broncoracing/bspd/README.md

# BSPD 
Bronco Racing Brake System Plausibility Device

Note: with the "no latch" option selected on the jumpers the output is inverted :(
