broncoracing/bspd/pcb/BSPD.kicad_pcb

## KiCad design pcb/BSPD.kicad_pcb (2023-02-06)

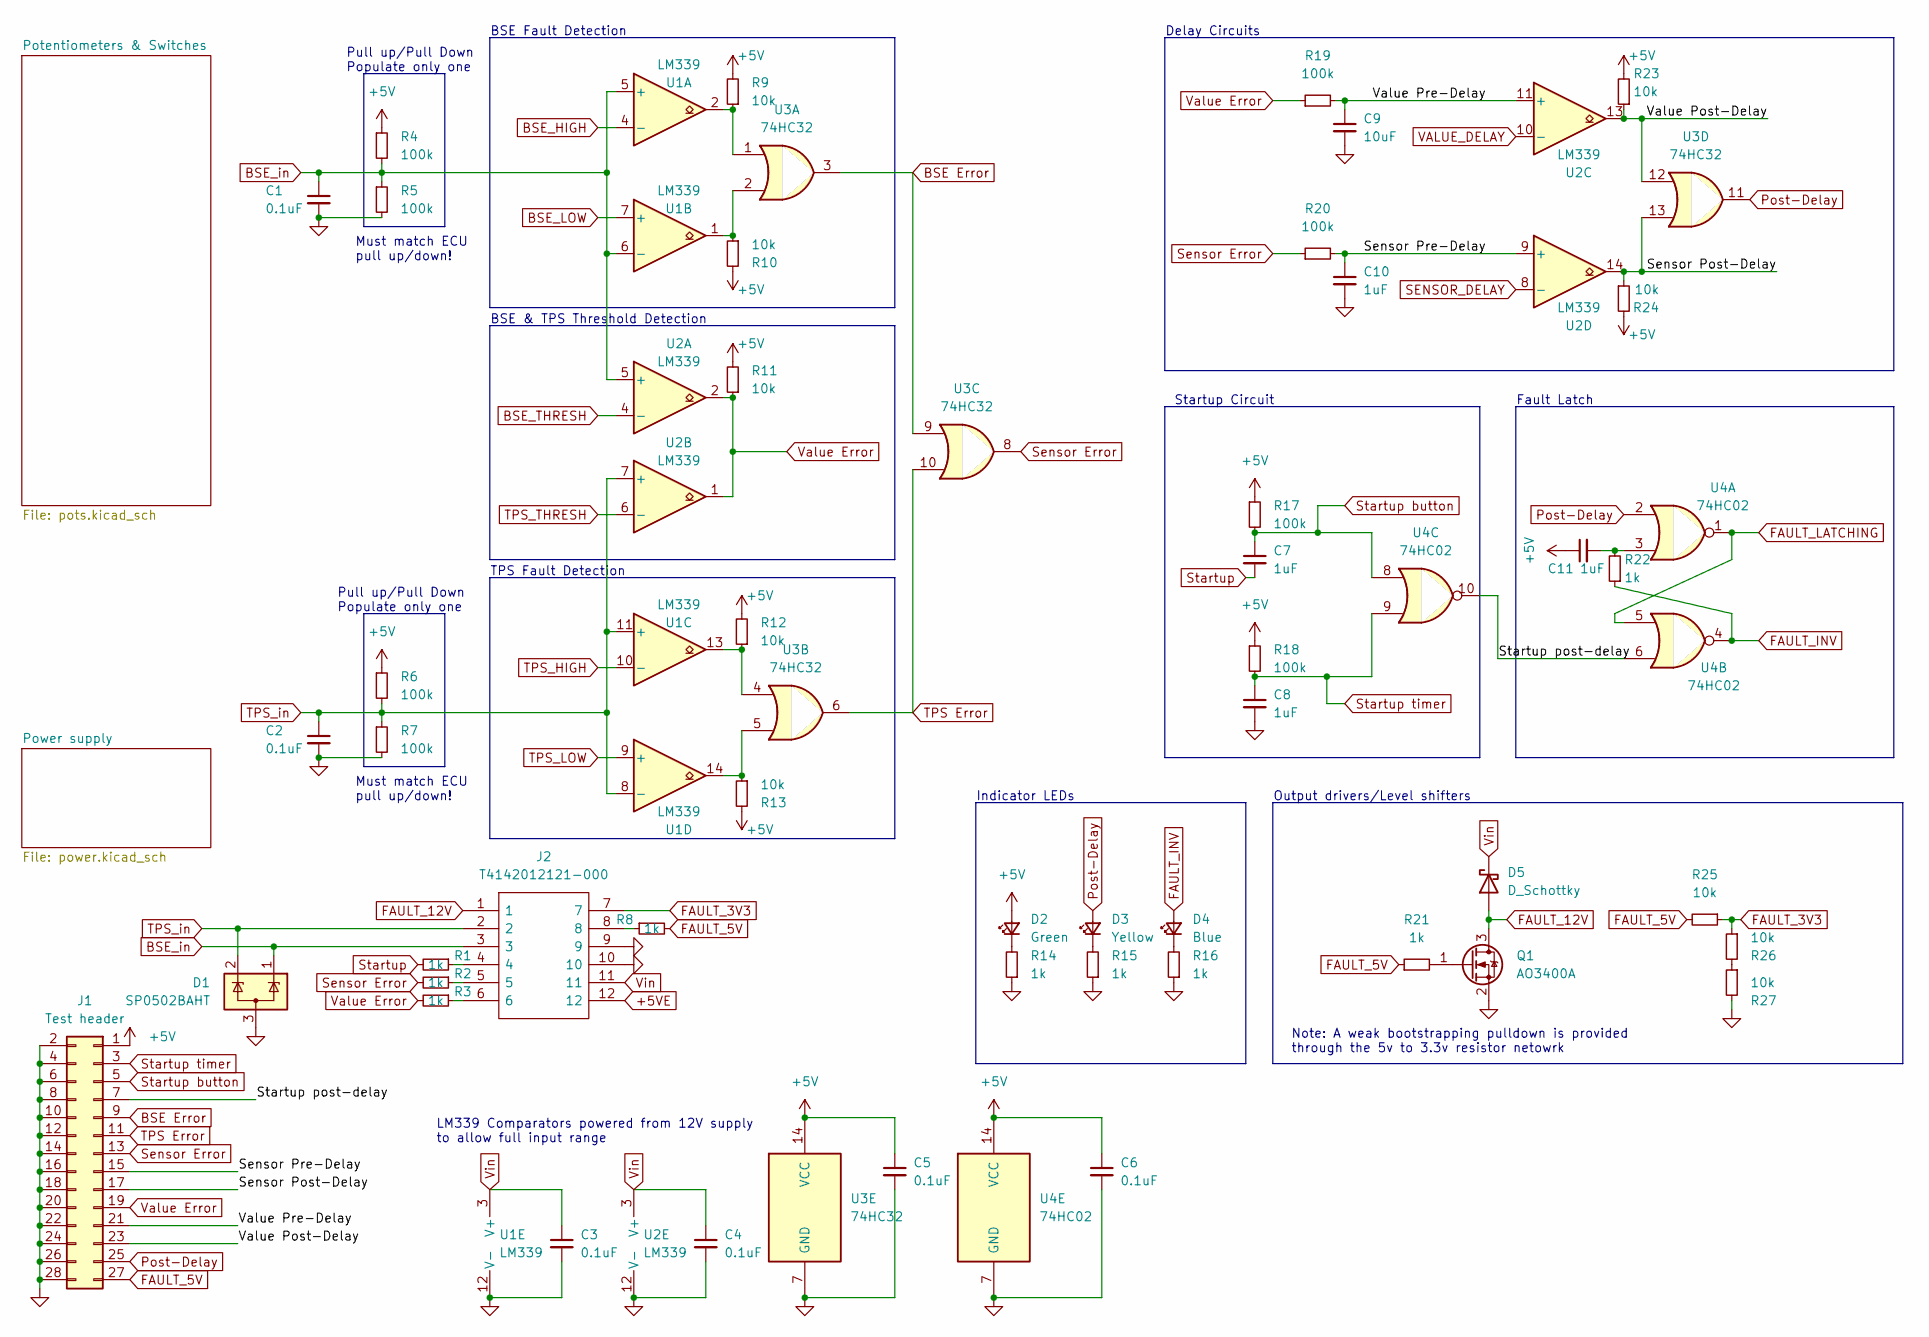
[picture p1: schematic BSPD.kicad_sch, Brake System Plausibility Device]

Parts:
C1, C2, C3, C4, C5, C6: 0.1uF; C_0402_1005Metric; LCSC C307331
C7, C8, C10, C11: 1uF; C_0402_1005Metric; LCSC C52923
C9: 10uF; C_0805_2012Metric; LCSC C440198
D1: SP0502BAHT; SOT-23; LCSC C32677
D2: Green; LED_0603_1608Metric; LCSC C72043
D3: Yellow; LED_0603_1608Metric; LCSC C72038
D4: Blue; LED_0603_1608Metric; LCSC C72041
D5: D_Schottky; D_SOD-323; LCSC C191023
J1: Test header; PinHeader_2x14_P2.54mm_Vertical
J2: T4142012121-000; T4140012121000; Mouser Part Number 571-T4142012121-000
Q1: AO3400A; SOT-23; LCSC C20917
R1, R2, R3, R8, R14, R15, R16, R21, R22: 1k; R_0402_1005Metric; LCSC C11702
R4, R5, R6, R7, R17, R18, R19, R20: 100k; R_0402_1005Metric; LCSC C25741
R9, R10, R11, R12, R13, R23, R24, R25, R26, R27: 10k; R_0402_1005Metric; LCSC C25744
U1, U2: LM339; SOIC-14_3.9x8.7mm_P1.27mm; LCSC C63821
U3: 74HC32; SOIC-14_3.9x8.7mm_P1.27mm; LCSC C6838
U4: 74HC02; SOIC-14_3.9x8.7mm_P1.27mm; LCSC C5588

Connections:
+5V: C5.1, C6.1, C11.1, D2.2 (A), J1.1, R4.1, R6.1, R9.2, R10.2, R11.2, R12.2, R13.2, R17.1, R18.1, R23.2, R24.2, U3.14 (VCC), U4.14 (VCC); also elsewhere on the board
+5VE: J2.12; also elsewhere on the board
/Sensor Post-Delay: J1.17, R24.1, U2.14, U3.13
/Sensor Pre-Delay: C10.1, J1.15, R20.2, U2.9 (+)
/Startup post-delay: J1.7, U4.6, U4.10
/Value Post-Delay: J1.23, R23.1, U2.13, U3.12
/Value Pre-Delay: C9.1, J1.21, R19.2, U2.11 (+)
BSE Error: J1.9, U3.3, U3.9
BSE_HIGH: U1.4 (-); also elsewhere on the board
BSE_LOW: U1.7 (+); also elsewhere on the board
BSE_THRESH: U2.4 (-); also elsewhere on the board
BSE_in: C1.1, D1.1 (K), J2.3, R4.2, R5.1, U1.5 (+), U1.6 (-), U2.5 (+)
FAULT_3V3: J2.7, R25.1, R26.1
FAULT_5V: J1.27, R8.2, R21.1, R25.2; also elsewhere on the board
FAULT_12V: D5.2 (A), J2.1, Q1.3 (D)
FAULT_INV: D4.2 (A), R22.1, U4.4
FAULT_LATCHING: U4.1, U4.5; also elsewhere on the board
GND: C1.2, C2.2, C3.2, C4.2, C5.2, C6.2, C8.2, C9.2, C10.2, D1.3 (A), J1.2, J1.4, J1.6, J1.8, J1.10, J1.12, J1.14, J1.16, J1.18, J1.20, J1.22, J1.24, J1.26, J1.28, J2.9, J2.10, Q1.2 (S), R5.2, R7.2, R14.1, R15.1, R16.1, R27.2, U1.12 (V-), U2.12 (V-), U3.7 (GND), U4.7 (GND); also elsewhere on the board
unnamed: C11.2, R22.2, U4.3
unnamed: D2.1 (K), R14.2
unnamed: D3.1 (K), R15.2
unnamed: D4.1 (K), R16.2
unnamed: J2.4, R1.1
unnamed: J2.5, R2.1
unnamed: J2.6, R3.1
unnamed: J2.8, R8.1
unnamed: Q1.1 (G), R21.2
unnamed: R9.1, U1.2, U3.1
unnamed: R10.1, U1.1, U3.2
unnamed: R12.1, U1.13, U3.4
unnamed: R13.1, U1.14, U3.5
unnamed: R26.2, R27.1
Post-Delay: D3.2 (A), J1.25, U3.11, U4.2; also elsewhere on the board
SENSOR_DELAY: U2.8 (-); also elsewhere on the board
Sensor Error: J1.13, R2.2, R20.1, U3.8
Startup: C7.2, R1.2; also elsewhere on the board
Startup button: C7.1, J1.5, R17.2, U4.8
Startup timer: C8.1, J1.3, R18.2, U4.9
TPS Error: J1.11, U3.6, U3.10
TPS_HIGH: U1.10 (-); also elsewhere on the board
TPS_LOW: U1.9 (+); also elsewhere on the board
TPS_THRESH: U2.6 (-); also elsewhere on the board
TPS_in: C2.1, D1.2 (K), J2.2, R6.2, R7.1, U1.8 (-), U1.11 (+), U2.7 (+)
VALUE_DELAY: U2.10 (-); also elsewhere on the board
Value Error: J1.19, R3.2, R11.1, R19.1, U2.1, U2.2
Vin: C3.1, C4.1, D5.1 (K), J2.11, U1.3 (V+), U2.3 (V+); also elsewhere on the board

Notes on the sheet:
Pull up/Pull Down Populate only one
Delay Circuits
Fault Latch
TPS Fault Detection
LM339 Comparators powered from 12V supply to allow full input range
Startup Circuit
Must match ECU pull up/down!
Indicator LEDs
Output drivers/Level shifters
BSE Fault Detection
BSE & TPS Threshold Detection
Note: A weak bootstrapping pulldown is provided through the 5v to 3.3v resistor netowrk

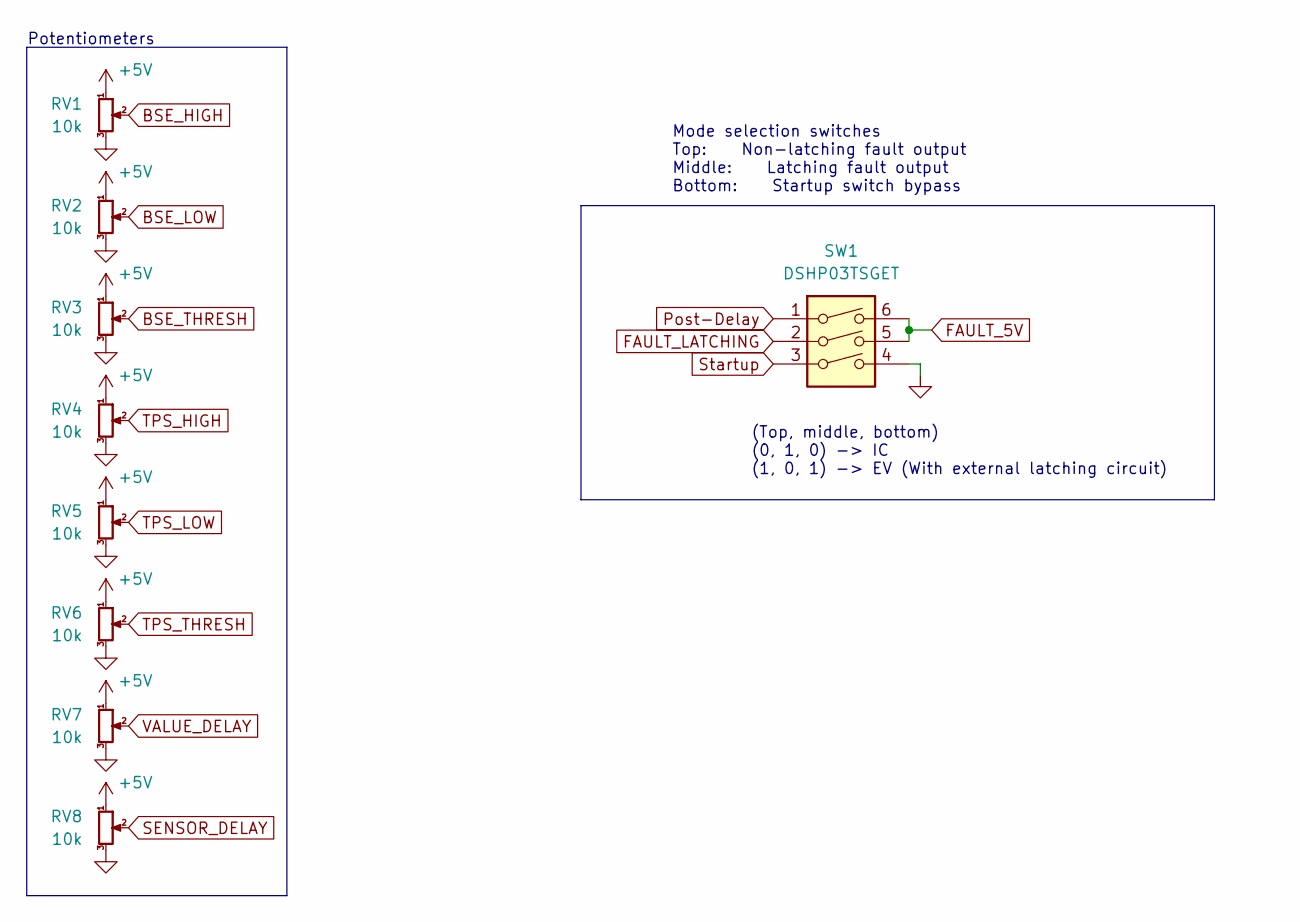
[picture p2: schematic pots.kicad_sch]

Parts:
RV1, RV2, RV3, RV4, RV5, RV6, RV7, RV8: 10k; Potentiometer_Bourns_TC33X_Vertical; LCSC C719176
SW1: DSHP03TSGET; SW_DIP_SPSTx03_Slide_KingTek_DSHP03TS_W7.62mm_P1.27mm; LCSC C50844

Connections:
+5V: RV1.1, RV2.1, RV3.1, RV4.1, RV5.1, RV6.1, RV7.1, RV8.1; also elsewhere on the board
BSE_HIGH: RV1.2; also elsewhere on the board
BSE_LOW: RV2.2; also elsewhere on the board
BSE_THRESH: RV3.2; also elsewhere on the board
FAULT_5V: SW1.5, SW1.6; also elsewhere on the board
FAULT_LATCHING: SW1.2; also elsewhere on the board
GND: RV1.3, RV2.3, RV3.3, RV4.3, RV5.3, RV6.3, RV7.3, RV8.3, SW1.4; also elsewhere on the board
Post-Delay: SW1.1; also elsewhere on the board
SENSOR_DELAY: RV8.2; also elsewhere on the board
Startup: SW1.3; also elsewhere on the board
TPS_HIGH: RV4.2; also elsewhere on the board
TPS_LOW: RV5.2; also elsewhere on the board
TPS_THRESH: RV6.2; also elsewhere on the board
VALUE_DELAY: RV7.2; also elsewhere on the board

Notes on the sheet:
Mode selection switches Top: Non-latching fault output Middle: Latching fault output Bottom: Startup switch bypass
Potentiometers
(Top, middle, bottom) (0, 1, 0) -> IC (1, 0, 1) -> EV (With external latching circuit)

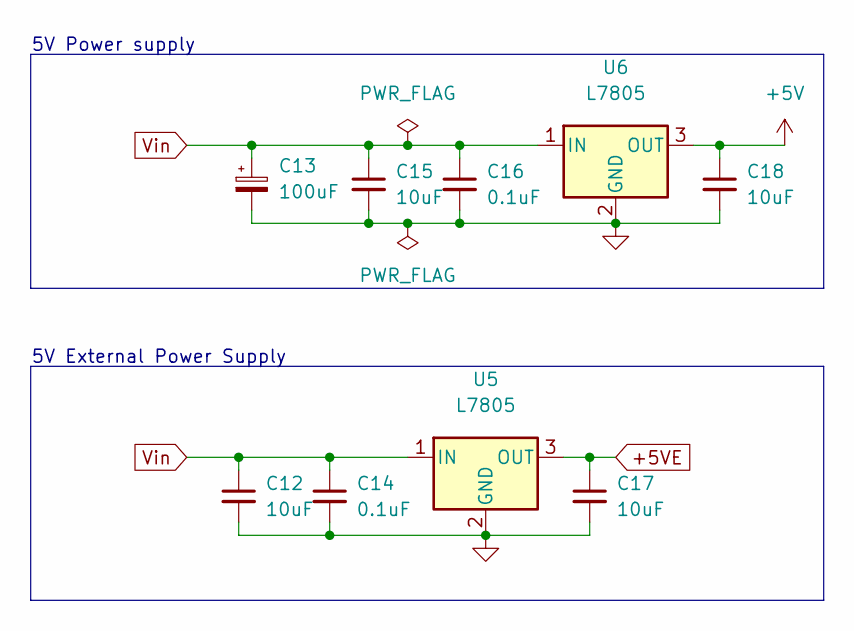
[picture p3: schematic power.kicad_sch]

Parts:
C12, C15, C17, C18: 10uF; C_0805_2012Metric; LCSC C440198
C13: 100uF; C_Elec_6.3x7.7; LCSC C2836437
C14, C16: 0.1uF; C_0402_1005Metric; LCSC C307331
U5, U6: L7805; TO-252-2; LCSC C897464

Connections:
+5V: C18.1, U6.3 (OUT); also elsewhere on the board
+5VE: C17.1, U5.3 (OUT); also elsewhere on the board
GND: C12.2, C13.2, C14.2, C15.2, C16.2, C17.2, C18.2, U5.2 (GND), U6.2 (GND); also elsewhere on the board
Vin: C12.1, C13.1, C14.1, C15.1, C16.1, U5.1 (IN), U6.1 (IN); also elsewhere on the board

Notes on the sheet:
5V External Power Supply
5V Power supply

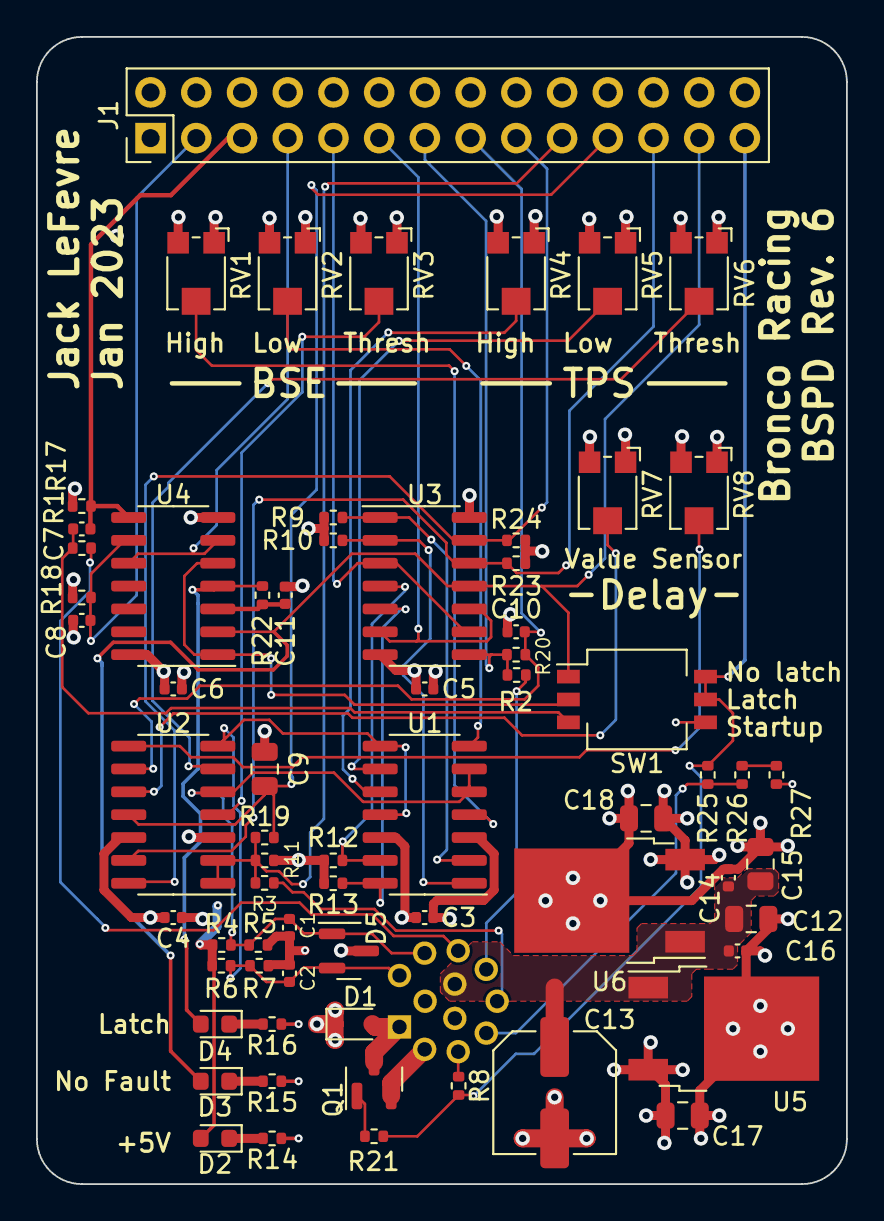
[picture p4: board BSPD.kicad_pcb from above]

Board: 4 copper layers, 45.0 x 63.7 mm, 68 parts (1 on the bottom side), 46 nets.
