broncoracing/bspd/(commit log)

2021-02-13 initial commit of V3. Layout not updated
    [3 inp or gate.PcbLib, B6B-PH-SM4-TB_LF__SN_.PcbLib, B6B-PH-SM4-TB_LF__SN_.SchLib, BSPD Part List.xlsx, BSPDPCB.PcbDoc, BSPDSchematic.SchDoc, Brake_System_Plausibility_Device.PrjPcb, CL05A105MQ5NNNC.PcbLib]
2021-02-17 Updates, need to check traces still
    - added 4 more +5 caps
    - relocated components for better traces
    - still need to go thru and check for bad traces.
    [BSPDPCB.PcbDoc, BSPDSchematic.SchDoc, Brake_System_Plausibility_Device.PrjPcb]
2021-02-17 Fixed all the bad traces, no drc or unrouted violation
    [BSPDPCB.PcbDoc]
2021-02-18 Added digikey cart, Relay is backordered
    [2021-02-17T190602.csv, 2021-02-17T190602.xlsx, BSPDPCB.PcbDoc, BSPDSchematic.SchDoc]
2021-02-20 Fixed ling power and ground via traces. checked every part to confirm power and ground connection.
    [BSPDPCB.PcbDoc, BSPDSchematic.SchDoc]
2021-02-20 shortened some traces
    [BSPDPCB.PcbDoc, BSPDSchematic.SchDoc]
2021-02-20 Version 3 completed and ordered
    [2021-02-17T190602.xlsx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]
2021-03-17 Fixed mosfet logic, updated Regulator, Gerbers v4
    [BSPD Part List.xlsx, BSPDPCB.PcbDoc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]
2021-03-22 Fixed pull up before mosfet
    [BSPDPCB.PcbDoc, BSPDSchematic.SchDoc]
2021-04-01 Updated the V Reg name to correct one
    [BSPDPCB.PcbDoc, BSPDSchematic.SchDoc]
2022-05-25 cleanup useless files, update gitignore
    [BSPDPCB_Copper_Plane_1.gbr, BSPDPCB_Copper_Plane_2.gbr, BSPDPCB_Copper_Signal_Bot.gbr, BSPDPCB_Copper_Signal_Top.gbr, BSPDPCB_Keep-out.gbr, BSPDPCB_Legend_Bot.gbr, BSPDPCB_Legend_Top.gbr, BSPDPCB_Mechanical_1.gbr]
2023-02-06 Rev6 (#3)
    * Switched to KiCad
    * Schematic/layout for new revision
    * Switched to vertical DTM header
    * Fix kibot
    * Fixed flyback/reverse polarity protection, added part #s
    * Switch to M12 Connector, fix comparator issue from rev 5
    * Added jlc part number for 7805
    * Added jlc part number for dip switches
    [3 inp or gate.PcbLib, B6B-PH-SM4-TB_LF__SN_.PcbLib, B6B-PH-SM4-TB_LF__SN_.SchLib, BSPD Part List.xlsx, BSPD.kicad_pcb, BSPD.kicad_sch, BSPDPCB.PcbDoc, BSPDSchematic.SchDoc]
